Vahlar/projet_elec_meteo/Lucile_Comba/Images/Oscillo_Interruption_Anemometre.jpg

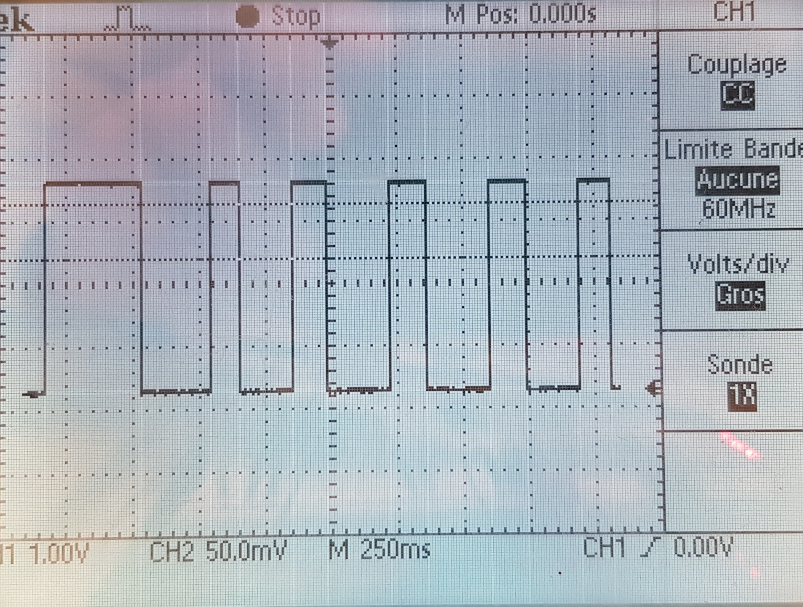
Lucile_Comba/Images/Oscillo_Interruption_Anemometre.jpg
