Vahlar/projet_elec_meteo/Nicolas_Imbard/Nicolas_Imbard.md

CR 10/09/2020:  

- Prise de connaissance du projet.  
- création du repo Git et ajout des collaborateurs.  
- Lecture du travail effectué par la promotion précédente.  

CR 25/09/2020

- rédaction du cahier des charges du projet.
- câblage du BME280 et du FTDI232 à l'ESP32.

CR 08/10/2020

- câblage du TSL2591
- test du TSL2591 et du BME280

CR 22/10/2020

- soudage des prises rj11 femelles
- câble des modules Lora
- mise en place des capteurs de pluviométrie et d'anémométrie pour les tests

CR 19/11/2020

- Câblage et test du pluviomètre
- Analyse du câblage suite à plusieurs problèmes rencontrés
- Test de transmission des trames LoRa

CR 26/11/2020

- Test du code de l'anémomètre (problème de rebonds pour le moment)

CR 03/12/2020

-Absent
