Vahlar/projet_elec_meteo/Présentations/Présentation mi-parcours Météo.pdf

# Présentation mi-parcours Projet Ruche

# Station météologique

1 Guillaume BOUCHARD - Lucile COMBA--ANTONETTI - Nicolas HEISSLER Nicolas IMBARD - Loris MAGNE

I. Présentation du projet
II. | Avancement du projet
III. | Hardware
A. Fonctionnement des capteurs
B. Dimensionnement et câblage
C. Tests du fonctionnement des codes
D. Résolution des problèmes
E. PCB

IV. Développement logiciel
A. Capteur de pression / altitude / humidité / température
B. Capteur de luminosité
C. Pluviomètre
D. Anémomètre
E. Girouette
F. Module LoRa
G. Gestion du mode sommeil
V. | Conclusion | 2

# Sommaire

# I) Présentation

Objectifs du module Météo :

- Relever la température, l’humidité, l’altitude, de la pluviométrie, la direction et la vitesse du vent ;
- Réceptionner les données transmises par les autres modules ;


- Transmettre la totalité des données à la base de données.

# II) Avancement du projet

Mois Tâches | 09 | 10 | 11 | 12 | 01 | 02 | 03 | 04 | 05

Câblage des différents éléments / FTDI

Capteur de pression/altitude/humidité/température

Capteur de luminosité

Pluviomètre

Girouette

Anémomètre

Module LoRa

Gestion du mode sommeil

PCB

# III) Hardware

# A) Fonctionnement des capteurs

Capteur BME

Mesures :

- Pression (300 à 1100 hPa)
- Altitude
Humidité (%)
- Température (-40 à 85°C)

Alimentation :

- min 1.7v
- max 3.6v
I²C interface :
- SCK: serial clock (SCL)
- SDI: data (SDA)


- SDO: Slave address LSB ADC : 16 bit

# III) Hardware

# A) Fonctionnement des capteurs

Capteur TSL

Mesure :

- Luminosité (0,1 à 40 000 lux)

Alimentation :

- min 2.7v
- max 3.6v

I²C interface :

- SCL: serial clock
- SDA: data

ADC : 16 bit

# III) Hardware

# A) Fonctionnement des capteurs

Girouette; Anémomètre; Mesures :; - Précipitation

Pluviomètre

- Orientation du vent
- Vitesse du vent

# III) Hardware

# A) Fonctionnement des capteurs

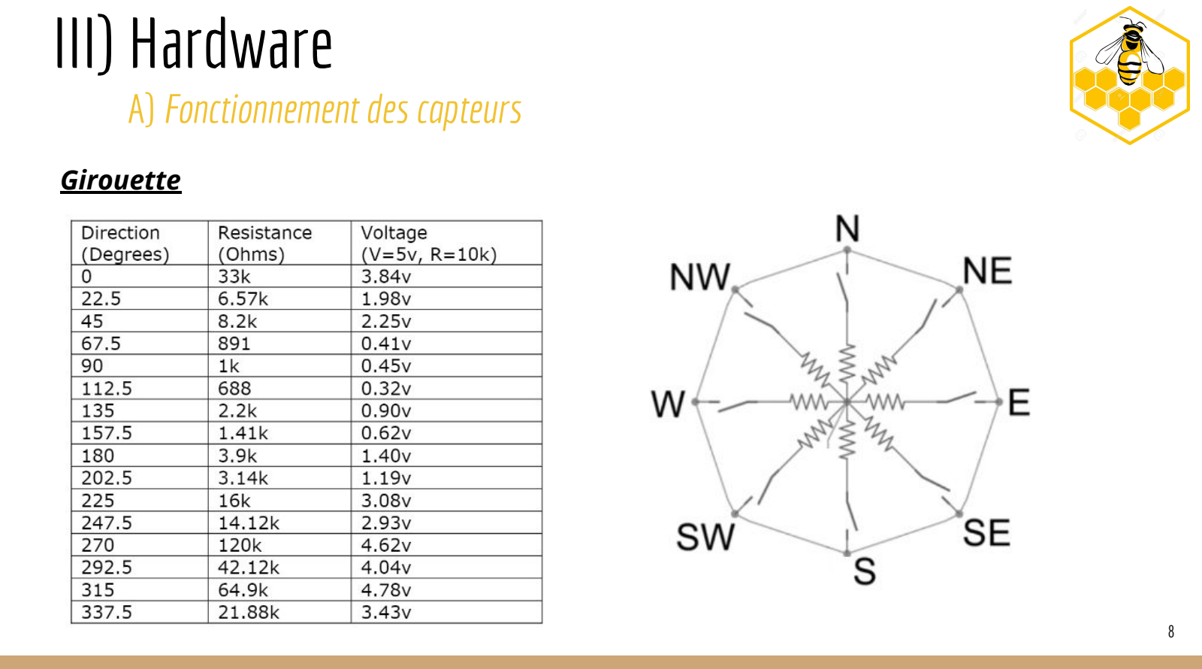
[picture p80: page 8]

Girouette

# III) Hardware

# B) Dimensionnement et câblage

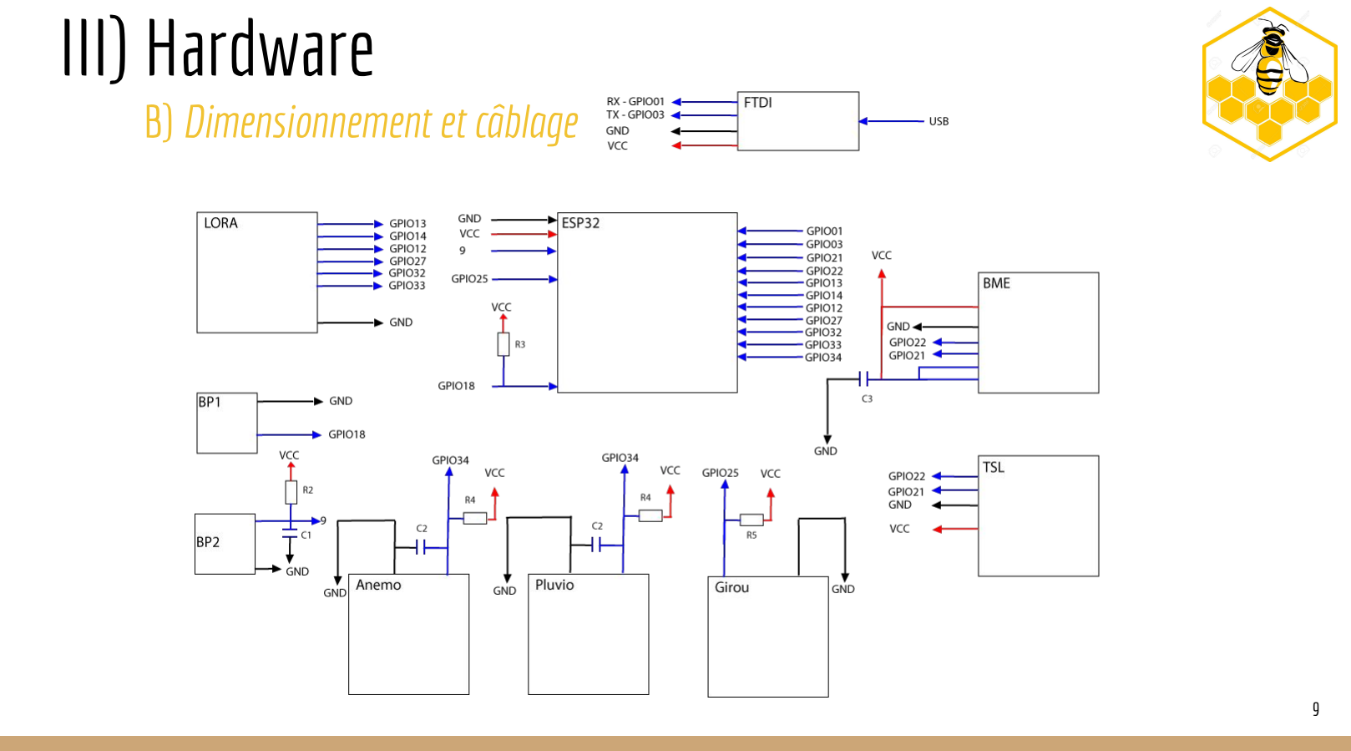
[picture p81: page 9]

# III) Hardware

# C) Tests du fonctionnement des codes

Capteur BME

Récupération des
valeurs, comparaison
avec météo france
Capteur TSL | Récupération des valeurs en Candela

Aucun problème rencontré lors des tests de fonctionnement

Conclusion

# III) Hardware

# C) Tests du fonctionnement des codes

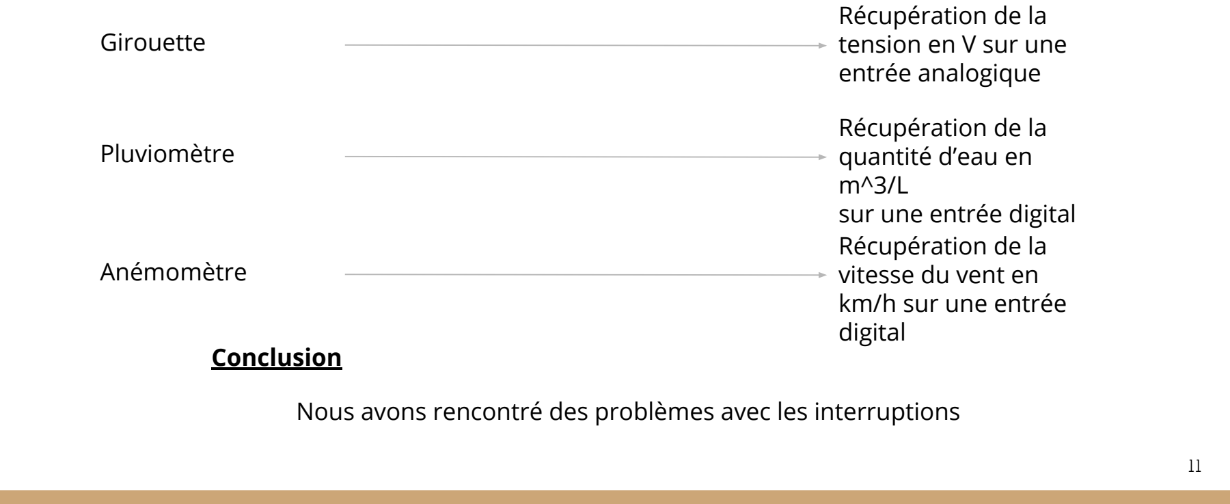
[picture p82: figure]
Girouette; Récupération de la tension en V sur une entrée analogique; Pluviomètre; Récupération de la quantité d’eau en m^3/L sur une entrée digital; Conclusion; Anémomètre; Récupération de la vitesse du vent en km/h sur une entrée digital

Nous avons rencontré des problèmes avec les interruptions

# III) Hardware

# D) Résolution des problèmes

Rajout d’une capacité de 220pF pour éviter les rebonds

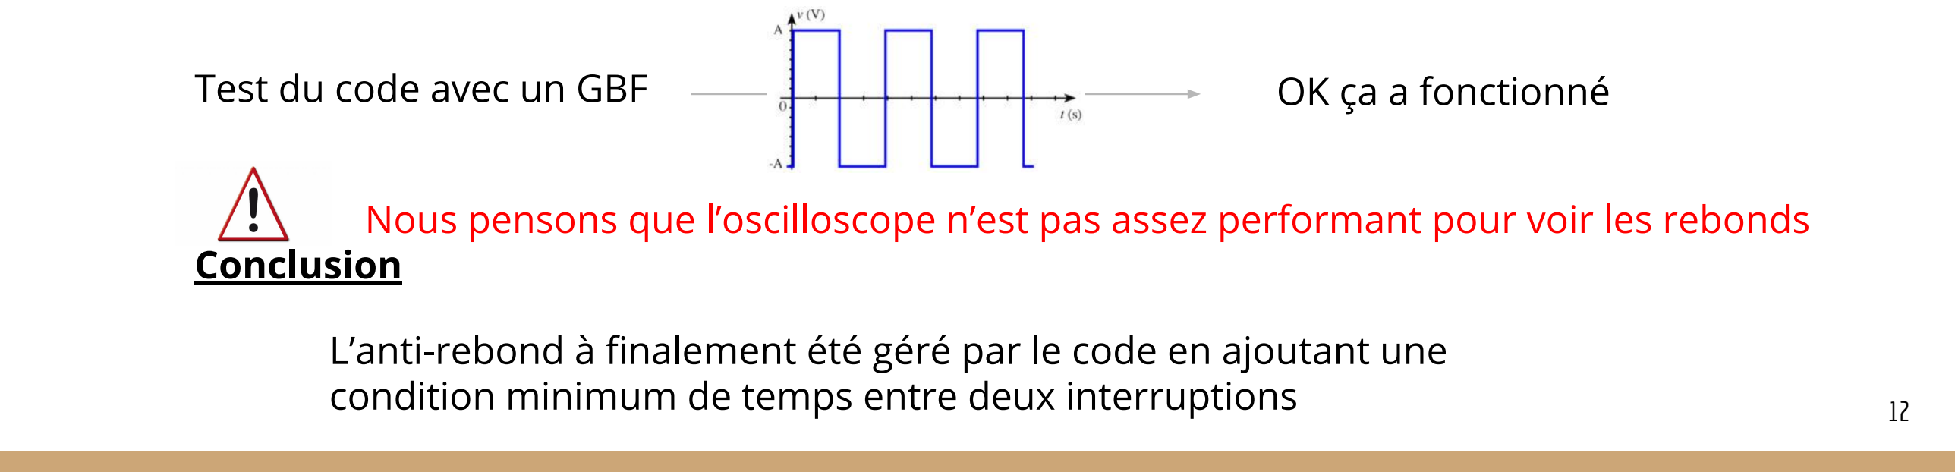
[picture p83: figure]
Conclusion

Test du code avec un GBF | OK ça a fonctionné

Vérification à l'oscilloscope
que les interruptions sont
propres

OK ça a fonctionné
la capacité a bien été dimensionné mais il n’est pas suffisant pour gérer entièrement notre problème d’interruption

L’anti-rebond à finalement été géré par le code en ajoutant une
condition minimum de temps entre deux interruptions

Nous pensons que l’oscilloscope n’est pas assez performant pour voir les rebonds

# III) Hardware

# E) PCB

1. Récupération du PCB existant
2. Suppression des composants inutiles
3. Ajout des librairies pour les composants existants
4. Séparation des différents éléments présents sur la carte en groupe ( acquisition, traitement, communication, action)

# IV) Développement logiciel


# A) Capteur de pression / altitude / humidité / température

Code capteur BME


# IV) Développement logiciel

# B) Capteur luminosité

Code capteur TSL

# IV) Développement logiciel

# C) Pluviomètre

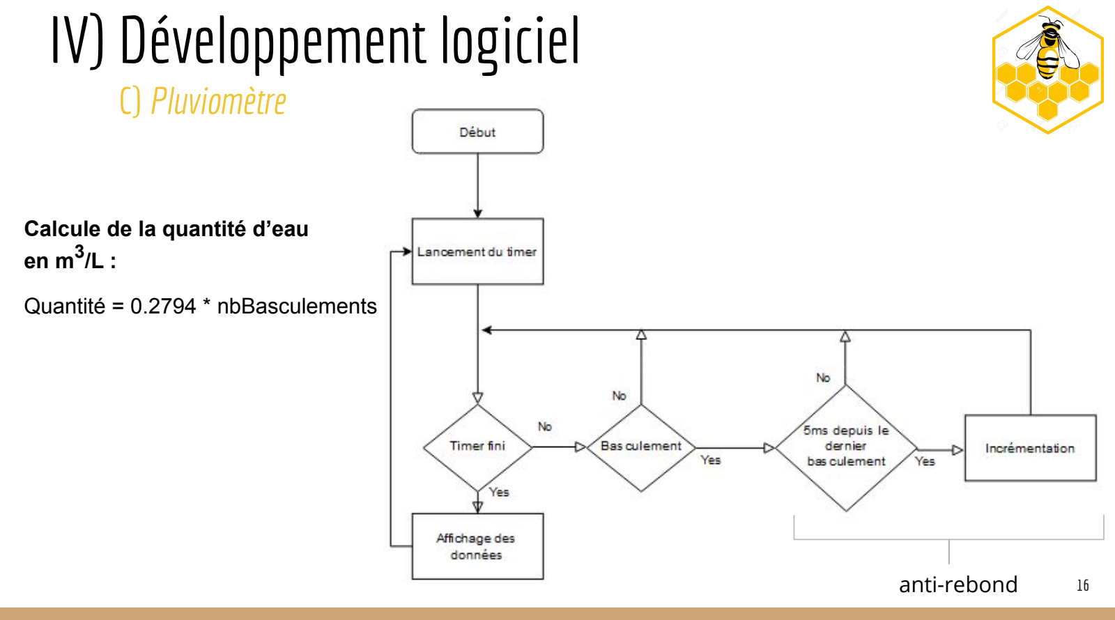
[picture p84: page 16]

anti-rebond 16

Calcule de la quantité d’eau
en m³
/L :

Quantité = 0.2794 * nbBasculements

# IV) Développement logiciel

# F) Anémomètre

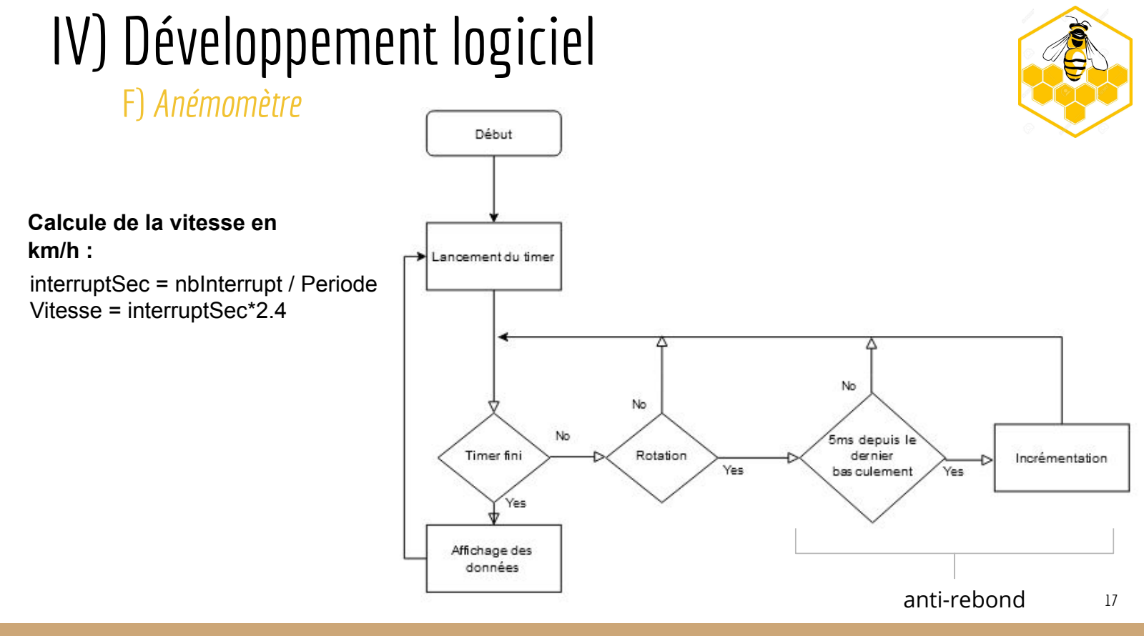
[picture p85: page 17]

anti-rebond | 17

interruptSec = nbInterrupt / Periode Vitesse = interruptSec*2.4

Calcule de la vitesse en
km/h :

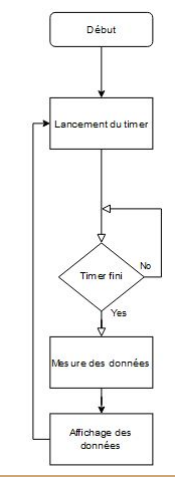
[picture p86: figure]

# IV) Développement logiciel

# E) Girouette

La lecture d'une valeur analogique avec l'ESP32 signifie que l’on peut mesurer différents niveaux de tension entre 0 V et 3,3 V.

La tension mesurée est alors affectée à une valeur comprise entre 0 et 4095,

# IV) Développement logiciel

# E) Girouette

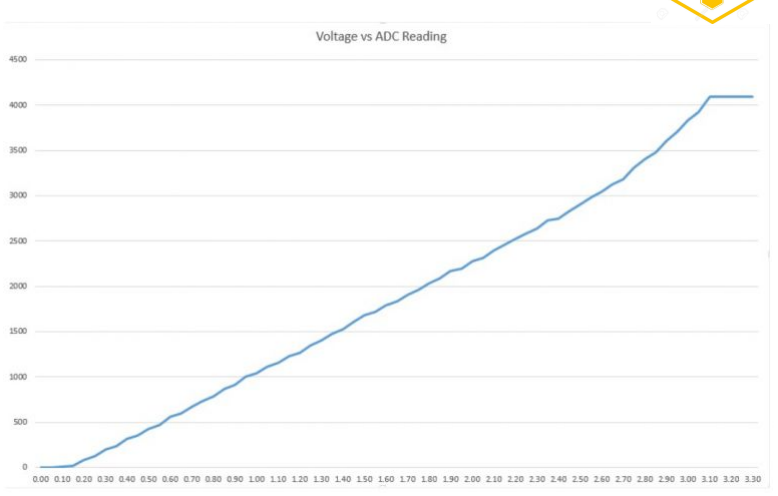
[picture p87: figure]

Problème : comportement non linéaire des broches ESP32 ADC

ESP32 n'est pas capable de distinguer 3,3 V de 3,2 V => même valeur pour les deux tensions: 4095.

De même pour 0 V et 0,1 V, valeur obtenue => 0

# IV) Développement logiciel

# F) Module LoRa

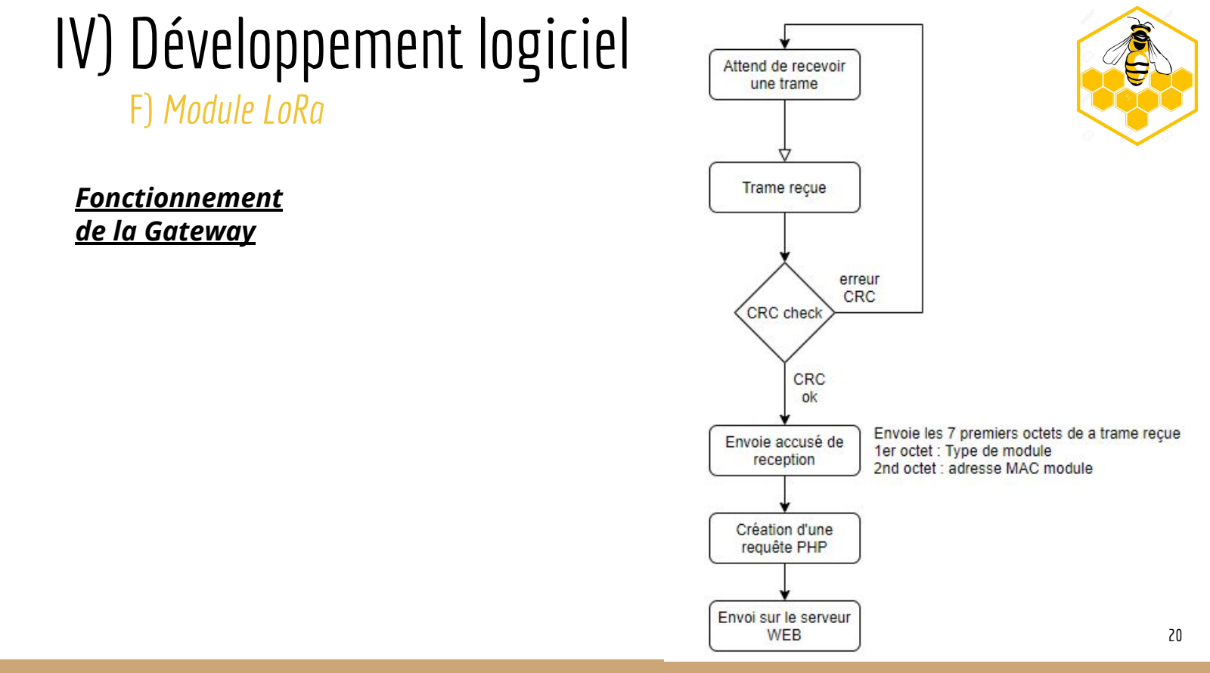
[picture p88: page 20]

Fonctionnement
de la Gateway

# IV) Développement logiciel


# F) Module LoRa

Envoie d’un message

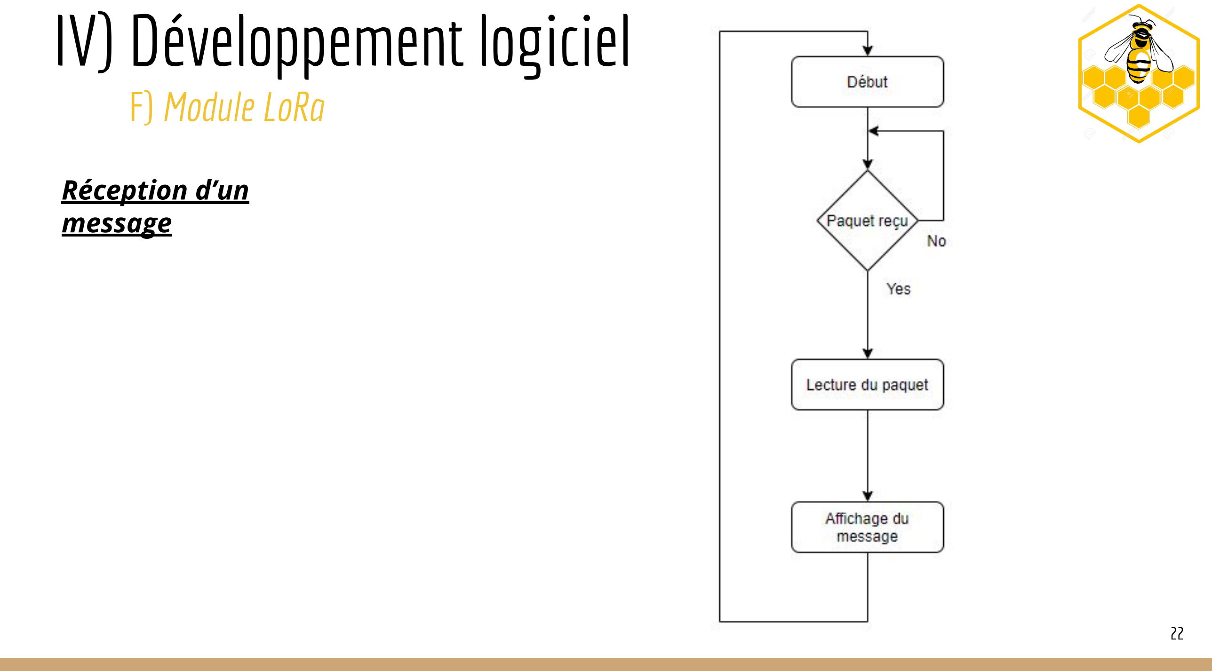
[picture p89: figure]
IV) Développement logiciel; F) Module LoRa; Réception d’un message

# IV) Développement logiciel

# G) Gestion du mode sommeil


# Conclusion

❏ Réalisation du PCB
❏ Test du module LORA
❏ Fin de la réalisation du code et test de la girouette

Merci de votre attention.

# Avez-vous des questions ?
