Vahlar/projet_elec_meteo/Loris_Magne/Fonctionnement Gateway.PNG

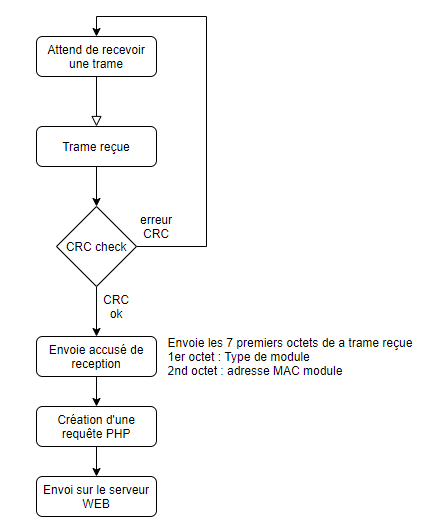
Loris_Magne/Fonctionnement Gateway.PNG
