Vahlar/projet_elec_meteo/Guillaume_Bouchard/Photo_test-continuité/Schema-test-de-continuité.png

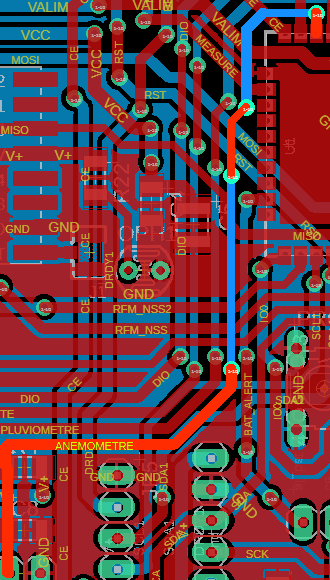
Guillaume_Bouchard/Photo_test-continuité/Schema-test-de-continuité.png
