Vahlar/projet_elec_meteo/Guillaume_Bouchard/ESP_LoRa_1.5.brd

## EAGLE design Guillaume_Bouchard/ESP_LoRa_1.5.brd (2021-04-01)

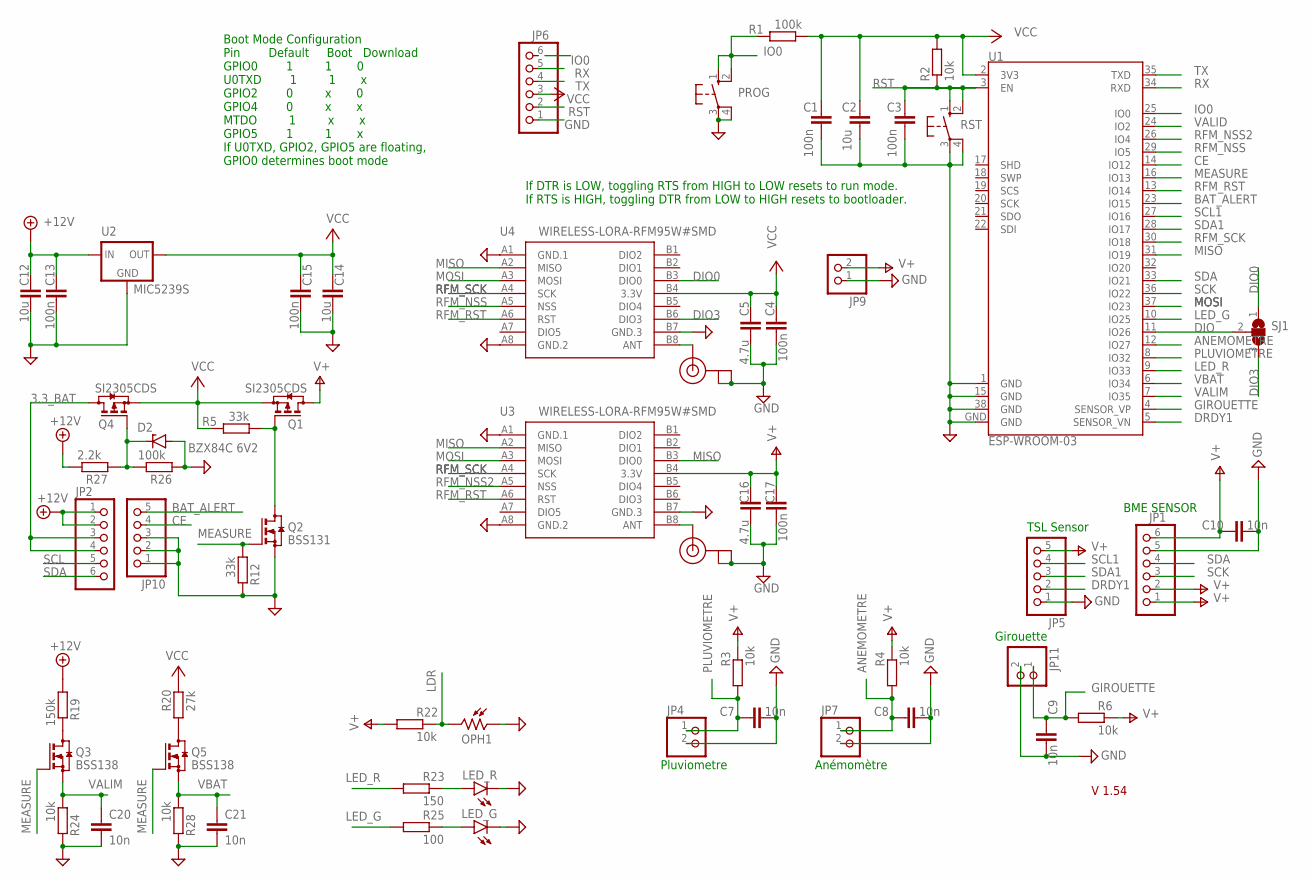
[picture p92: schematic ESP_LoRa_1.5.sch]

Parts:
C1, C3, C4, C13, C15, C17: 100n; C1206
C2, C12, C14: 10u; C1210
C5, C16: 4.7u; C1210
C7, C8, C9, C10, C20, C21: 10n; C1206
D2: BZX84C 6V2; TO236
J1, J2: U.FL
JP1, JP2, JP6: PINHD-1X6; 1X06
JP4, JP7, JP9, JP11: PINHD-1X2; 1X02
JP5, JP10: PINHD-1X5; 1X05
LED_G: LEDSMT1206; 1206
LED_R: LEDSMT1206; 1206
OPH1: VT93N2; VT900
PROG: 10-XX; B3F-10XX
Q1, Q4: SI2305CDS; SOT23
Q2: BSS131; SOT23
Q3, Q5: BSS138; SOT23
R1, R26: 100k; R1206
R2, R3, R4, R6, R22, R24, R28: 10k; R1206
R5, R12: 33k; R1206
R19: 150k; R1206
R20: 27k; R1206
R23: 150; R1206
R25: 100; R1206
R27: 2.2k; R1206
RST: 10-XX; B3F-10XX
SJ1: SJ2W; SJ_2
U1: ESP-WROOM-03
U2: MIC5239S; SOT223
U3, U4: WIRELESS-LORA-RFM95W#SMD

Connections:
3.3_BAT: JP2.3, JP2.4, Q4.3 (D)
+12V: C12.1, C13.1, JP2.1, JP2.2, R19.1, R27.2, U2.1 (IN)
ANEMOMETRE: C8.1, JP7.1, R4.1, U1.12 (IO27)
ANT2: J2.3 (SIGNAL), U4.B8 (ANT)
ANT3: J1.3 (SIGNAL), U3.B8 (ANT)
BAT_ALERT: JP10.5, U1.23 (IO15)
CE: JP10.4, U1.14 (IO12)
DIO: SJ1.2, U1.11 (IO26)
DIO0: SJ1.1, U4.B3 (DIO0)
DIO3: SJ1.3, U4.B6 (DIO3)
DRDY1: JP5.2, U1.5 (SENSOR_VN)
GIROUETTE: C9.1, JP11.1, R6.1, U1.4 (SENSOR_VP)
GND: C1.2, C2.2, C3.2, C4.2, C5.2, C7.2, C8.2, C9.2, C10.2, C12.2, C13.2, C14.2, C15.2, C16.2, C17.2, C20.2, C21.2, D2.A, J1.1 (GND), J1.2 (GND), J2.1 (GND), J2.2 (GND), JP1.5, JP4.2, JP5.1, JP6.1, JP7.2, JP9.1, JP10.1, JP10.2, JP10.3, JP11.2, LED_G.C, LED_R.C, OPH1.1, PROG.3, PROG.4 (P1), Q2.2 (S), R12.2, R24.2, R26.1, R28.2, RST.3, RST.4 (P1), U1.1 (GND), U1.15 (GND), U1.38 (GND), U1.GND, U2.2 (GND), U2.4 (GND), U3.A1 (GND.1), U3.A8 (GND.2), U3.B7 (GND.3), U4.A1 (GND.1), U4.A8 (GND.2), U4.B7 (GND.3)
IO0: PROG.1 (S), PROG.2 (S1), R1.2, U1.25 (IO0)
LDR: OPH1.2, R22.2
LED_G: R25.1, U1.10 (IO25)
LED_R: R23.1, U1.9 (IO33)
MEASURE: Q2.1 (G), Q3.1 (G), Q5.1 (G), R12.1, U1.16 (IO13)
MISO: U1.31 (IO19), U3.A2 (MISO), U3.B3 (DIO0), U4.A2 (MISO)
MOSI: U1.37 (IO23), U3.A3 (MOSI), U4.A3 (MOSI)
unnamed: Q1.1 (G), Q2.3 (D), R5.1
unnamed: Q3.3 (D), R19.2
unnamed: Q5.3 (D), R20.1
unnamed: LED_R.A, R23.2
unnamed: LED_G.A, R25.2
unnamed: D2.C, Q4.1 (G), R26.2, R27.1
PLUVIOMETRE: C7.1, JP4.1, R3.1, U1.8 (IO32)
RFM_NSS: U1.29 (IO5), U4.A5 (NSS)
RFM_NSS2: U1.26 (IO4), U3.A5 (NSS)
RFM_RST: U1.13 (IO14), U3.A6 (RST), U4.A6 (RST)
RFM_SCK: U1.30 (IO18), U3.A4 (SCK), U4.A4 (SCK)
RST: C3.1, JP6.2, R2.1, RST.1 (S), RST.2 (S1), U1.3 (EN)
RX: JP6.5, U1.34 (RXD)
SCK: JP1.3, U1.36 (IO22)
SCL: JP2.5
SCL1: JP5.4, U1.27 (IO16)
SDA: JP1.4, JP2.6, U1.33 (IO21)
SDA1: JP5.3, U1.28 (IO17)
TX: JP6.4, U1.35 (TXD)
V+: C10.1, C16.1, C17.1, JP1.1, JP1.2, JP1.6, JP5.5, JP9.2, Q1.3 (D), R3.2, R4.2, R6.2, R22.1, U3.B4 (3.3V)
VALID: U1.24 (IO2)
VALIM: C20.1, Q3.2 (S), R24.1, U1.7 (IO35)
VBAT: C21.1, Q5.2 (S), R28.1, U1.6 (IO34)
VCC: C1.1, C2.1, C4.1, C5.1, C14.1, C15.1, JP6.3, Q1.2 (S), Q4.2 (S), R1.1, R2.2, R5.2, R20.2, U1.2 (3V3), U2.3 (OUT), U4.B4 (3.3V)

Notes on the sheet:
If DTR is LOW, toggling RTS from HIGH to LOW resets to run mode. If RTS is HIGH, toggling DTR from LOW to HIGH resets to bootloader.
Boot Mode Configuration Pin Default Boot Download GPIO0 1 1 0 U0TXD 1 1 x GPIO2 0 x 0 GPIO4 0 x x MTDO 1 x x GPIO5 1 1 x If U0TXD, GPIO2, GPIO5 are floating, GPIO0 determines boot mode
V 1.54
TSL Sensor
BME SENSOR
Pluviometre
Anémomètre
Girouette

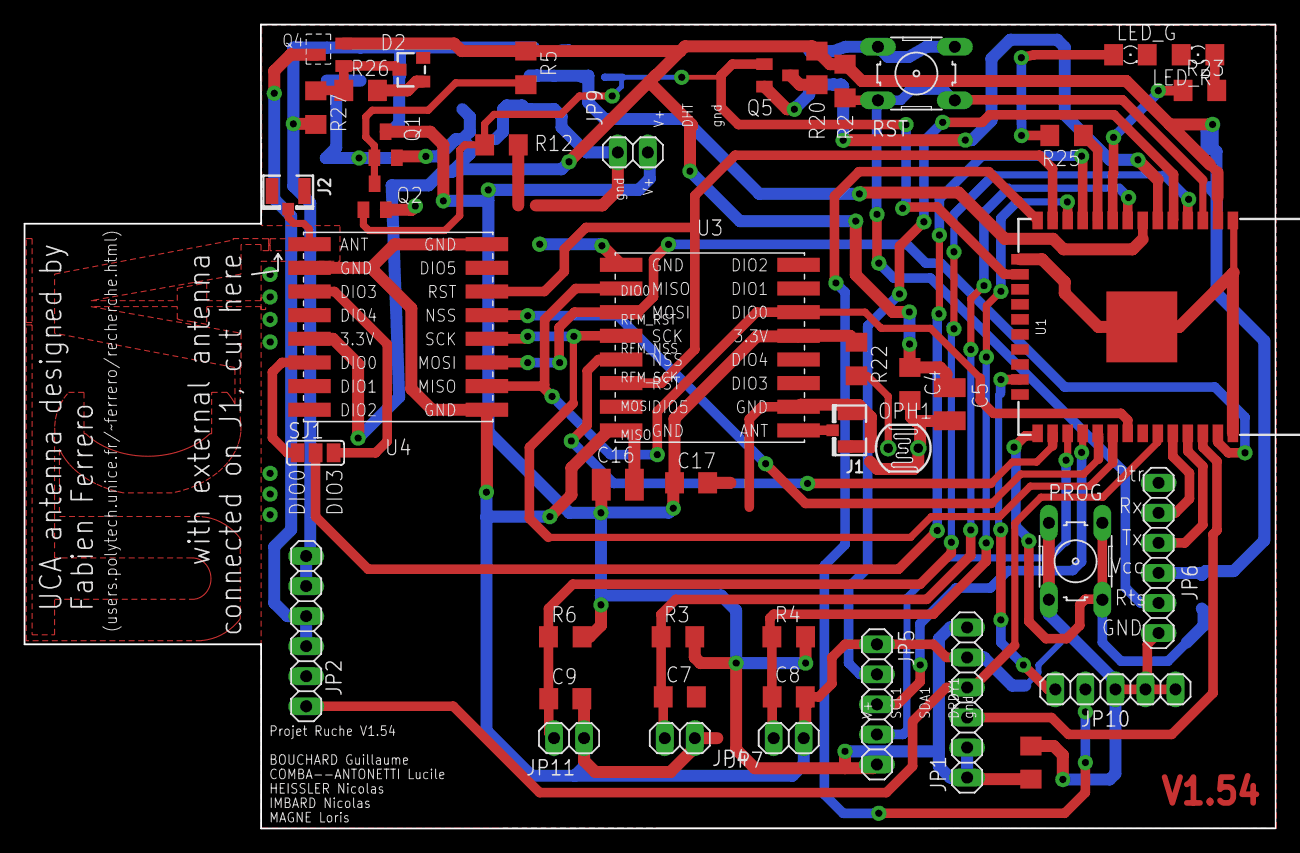
[picture p93: board ESP_LoRa_1.5.brd from above]

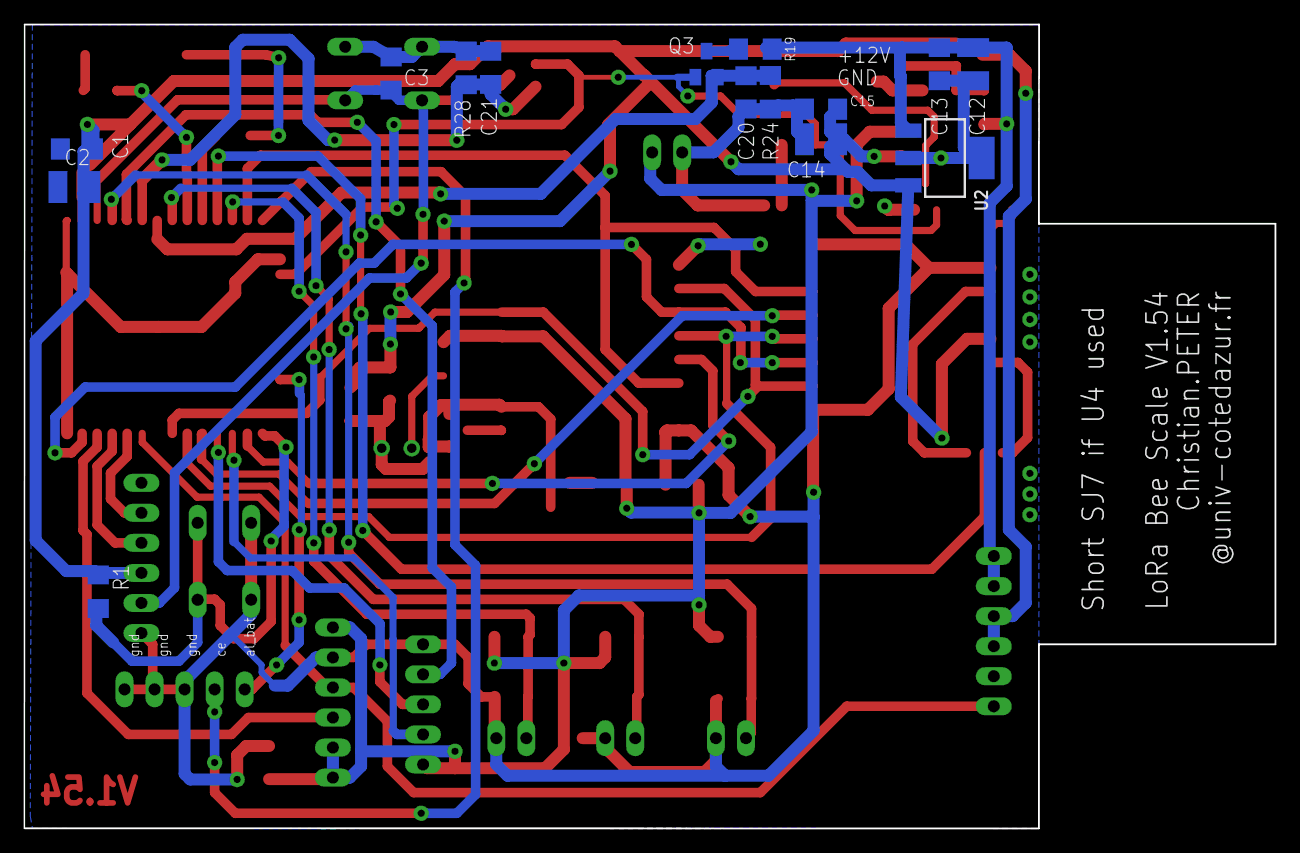
[picture p94: board ESP_LoRa_1.5.brd from below]

Board: 2 copper layers, 105.8 x 68.0 mm, 60 parts (15 on the bottom side), 42 nets.
