Vahlar/projet_elec_meteo/ESP_LoRa_Weather.brd

## EAGLE design ESP_LoRa_Weather.brd (2020-09-10)

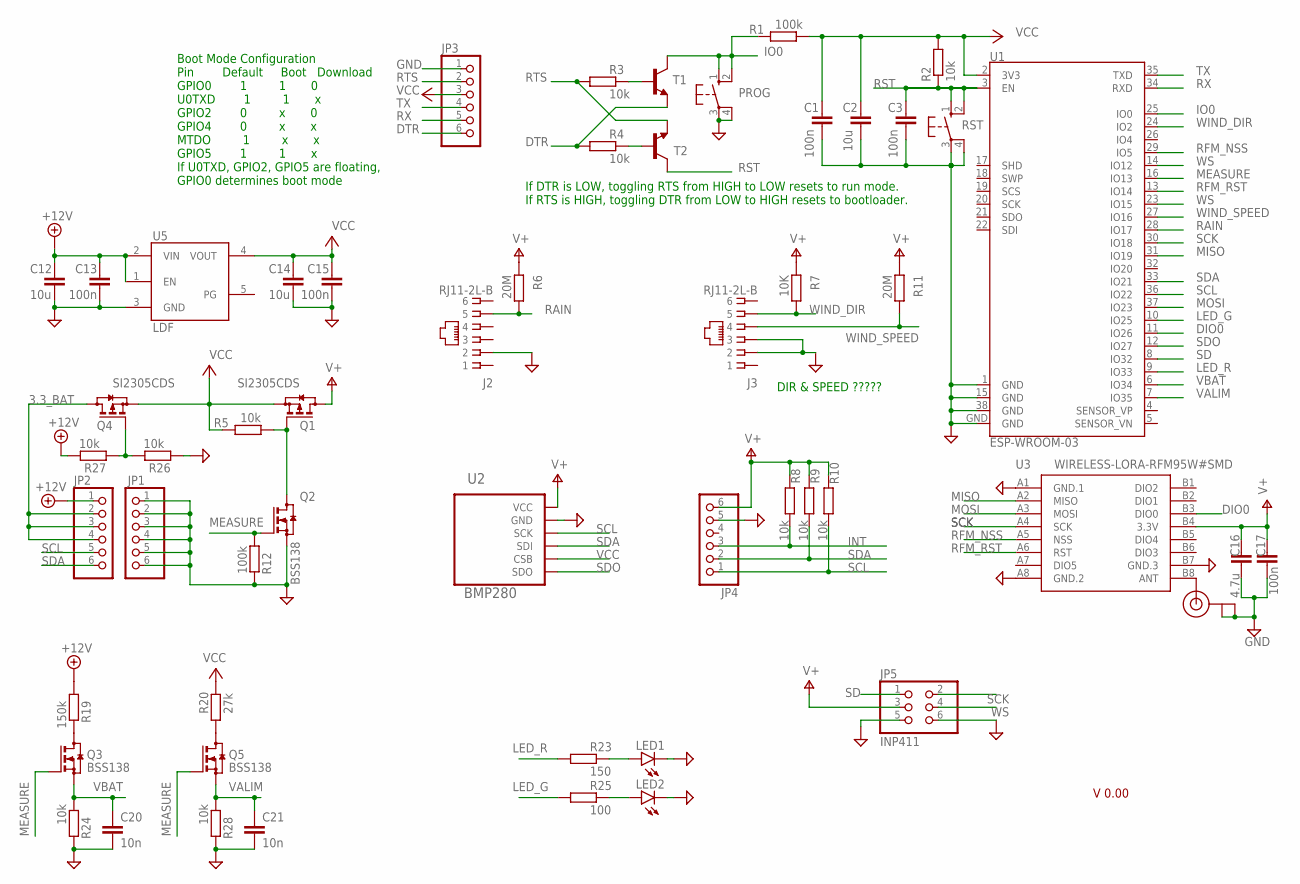
[picture p95: schematic ESP_LoRa_Weather.sch]

Parts:
C1, C3, C13, C15, C17: 100n; C1206
C2, C12, C14: 10u; C1210
C16: 4.7u; C1210
C20, C21: 10n; C1206
J1: U.FL
J2, J3: RJ11-2L-B; RJ11-NO_SHIELD
JP1, JP2, JP3, JP4: PINHD-1X6; 1X06
JP5: INP411; 2X03
LED1, LED2: LEDCHIPLED_0805; CHIPLED_0805
PROG: 10-XX; B3F-10XX
Q1, Q4: SI2305CDS; SOT23
Q2, Q3, Q5: BSS138; SOT23
R1, R12: 100k; R1206
R2, R3, R4, R5, R8, R9, R10, R24, R26, R27, R28: 10k; R1206
R6, R11: 20M; R1206
R7: 10K; R1206
R19: 150k; R1206
R20: 27k; R1206
R23: 150; R1206
R25: 100; R1206
RST: 10-XX; B3F-10XX
T1, T2: MMBT2222ALT1-NPN-SOT23-BEC; SOT23-BEC
U1: ESP-WROOM-03
U2: BMP280
U3: WIRELESS-LORA-RFM95W#SMD
U5: LDF3.3; PPAK

Connections:
3.3_BAT: JP2.2, JP2.3, JP2.4, Q4.3 (D)
+12V: C12.1, C13.1, JP2.1, R19.1, R27.2, U5.1 (EN), U5.2 (VIN)
DIO0: U1.11 (IO26), U3.B3 (DIO0)
DTR: JP3.6, R4.1, T1.E
GND: C1.2, C2.2, C3.2, C12.2, C13.2, C14.2, C15.2, C16.2, C17.2, C20.2, C21.2, J1.1 (GND), J1.2 (GND), J2.2, J3.2, J3.3, JP1.1, JP1.2, JP1.3, JP1.4, JP1.5, JP1.6, JP3.1, JP4.5, JP5.5, JP5.6, LED1.C, LED2.C, PROG.3, PROG.4 (P1), Q2.2 (S), R12.2, R24.2, R26.1, R28.2, RST.3, RST.4 (P1), U1.1 (GND), U1.15 (GND), U1.38 (GND), U1.GND, U2.GND, U3.A1 (GND.1), U3.A8 (GND.2), U3.B7 (GND.3), U5.3 (GND)
INT: JP4.3, R8.2
IO0: PROG.1 (S), PROG.2 (S1), R1.2, T1.C, U1.25 (IO0)
LED_G: R25.1, U1.10 (IO25)
LED_R: R23.1, U1.9 (IO33)
MEASURE: Q2.1 (G), Q3.1 (G), Q5.1 (G), R12.1, U1.16 (IO13)
MISO: U1.31 (IO19), U3.A2 (MISO)
MOSI: U1.37 (IO23), U3.A3 (MOSI)
unnamed: Q1.1 (G), Q2.3 (D), R5.1
unnamed: Q3.3 (D), R19.2
unnamed: J1.3 (SIGNAL), U3.B8 (ANT)
unnamed: Q5.3 (D), R20.1
unnamed: LED1.A, R23.2
unnamed: LED2.A, R25.2
unnamed: R3.2, T1.B
unnamed: R4.2, T2.B
unnamed: Q4.1 (G), R26.2, R27.1
RAIN: J2.5, R6.2, U1.28 (IO17)
RFM_NSS: U1.29 (IO5), U3.A5 (NSS)
RFM_RST: U1.13 (IO14), U3.A6 (RST)
RST: C3.1, R2.1, RST.1 (S), RST.2 (S1), T2.C, U1.3 (EN)
RTS: JP3.2, R3.1, T2.E
RX: JP3.5, U1.34 (RXD)
SCK: JP5.2, U1.30 (IO18), U3.A4 (SCK)
SCL: JP2.5, JP4.1, R10.2, U1.36 (IO22), U2.SCK
SD: JP5.1, U1.8 (IO32)
SDA: JP2.6, JP4.2, R9.2, U1.33 (IO21), U2.SDI
SDO: U1.12 (IO27), U2.SD0 (SDO)
TX: JP3.4, U1.35 (TXD)
V+: C16.1, C17.1, JP4.6, JP5.3, Q1.3 (D), R6.1, R7.1, R8.1, R9.1, R10.1, R11.1, U2.VCC, U3.B4 (3.3V)
VALIM: C21.1, Q5.2 (S), R28.1, U1.7 (IO35)
VBAT: C20.1, Q3.2 (S), R24.1, U1.6 (IO34)
VCC: C1.1, C2.1, C14.1, C15.1, JP3.3, Q1.2 (S), Q4.2 (S), R1.1, R2.2, R5.2, R20.2, U1.2 (3V3), U2.CSB, U5.4 (VOUT)
WIND_DIR: J3.5, R7.2, U1.24 (IO2)
WIND_SPEED: J3.4, R11.2, U1.27 (IO16)
WS: JP5.4, U1.14 (IO12), U1.23 (IO15)

Notes on the sheet:
If DTR is LOW, toggling RTS from HIGH to LOW resets to run mode. If RTS is HIGH, toggling DTR from LOW to HIGH resets to bootloader.
Boot Mode Configuration Pin Default Boot Download GPIO0 1 1 0 U0TXD 1 1 x GPIO2 0 x 0 GPIO4 0 x x MTDO 1 x x GPIO5 1 1 x If U0TXD, GPIO2, GPIO5 are floating, GPIO0 determines boot mode
V 0.00
DIR & SPEED ?????

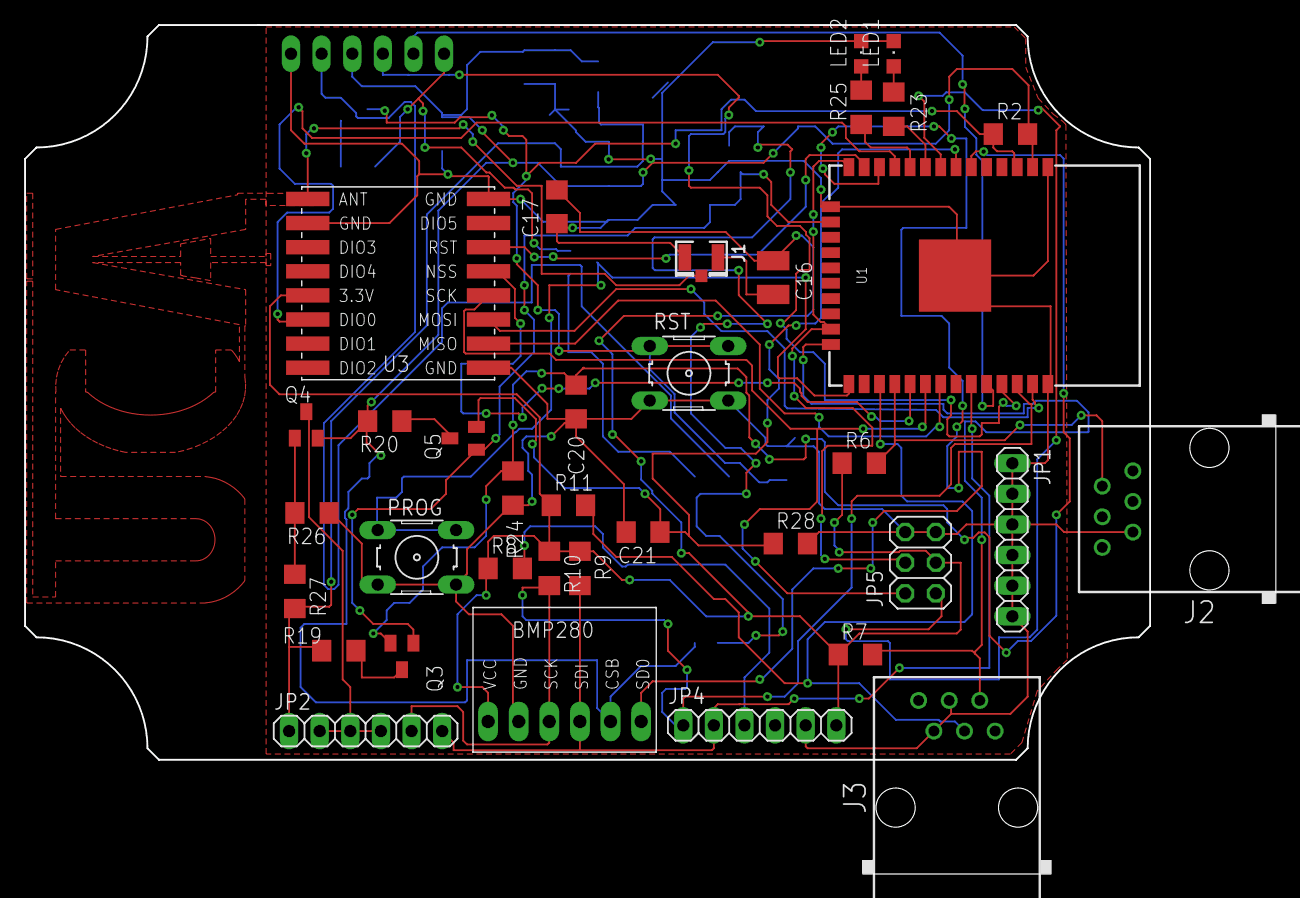
[picture p96: board ESP_LoRa_Weather.brd from above]

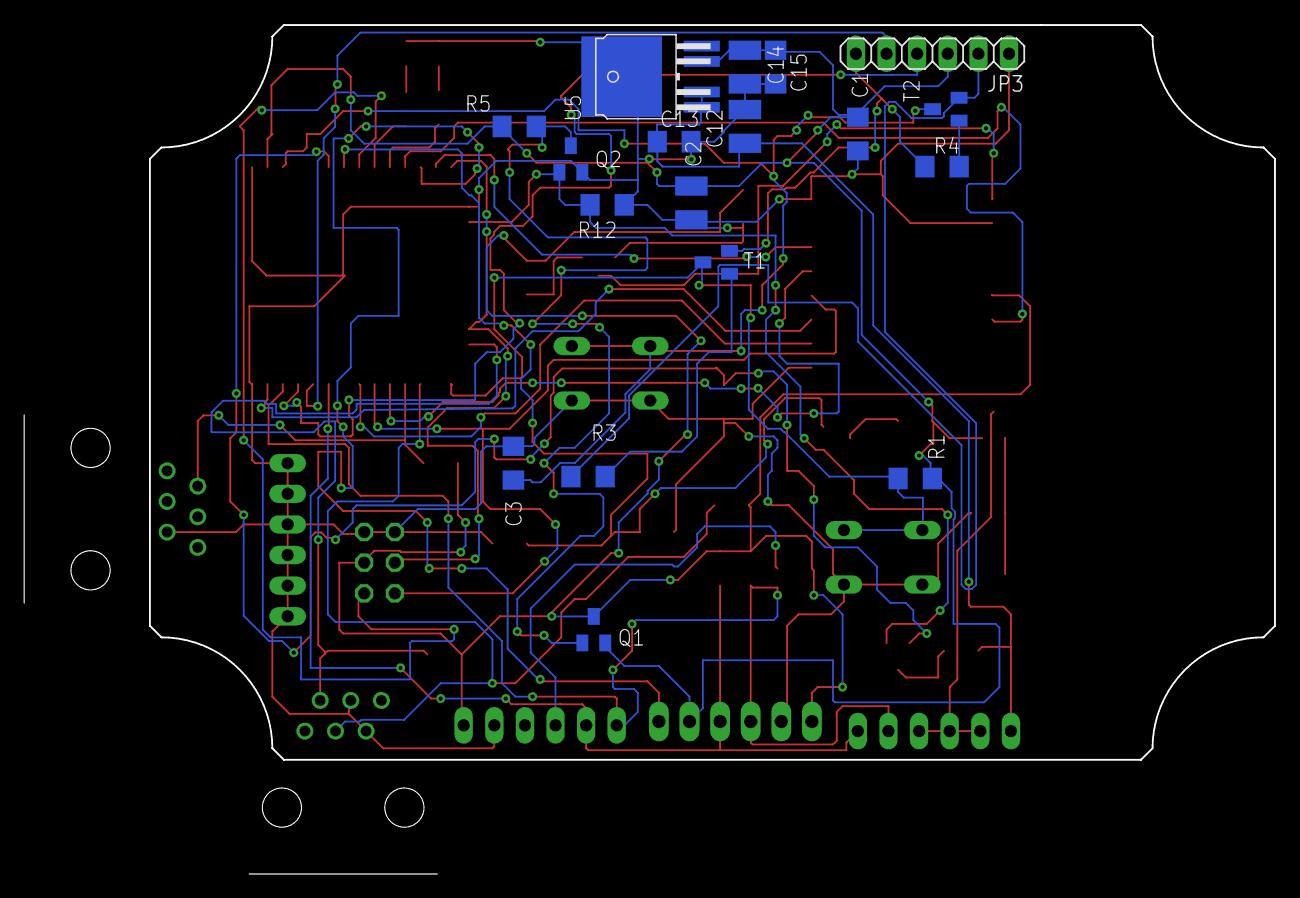
[picture p97: board ESP_LoRa_Weather.brd from below]

Board: 2 copper layers, 93.3 x 61.0 mm, 54 parts (18 on the bottom side), 40 nets.
