Vahlar/projet_elec_meteo/(commit log)

2020-09-10 add docs
    [ESP_LoRa_Weather.brd, ESP_LoRa_Weather.sch]
2020-09-10 Suppression du fichier inutile + copie du code arduino
2020-09-10 Suppression de test + Mise a jour du document taches projet
2020-09-10 Mise à jour du fichier des tâches par séance
2020-09-25 -Mise à jour du code 1.0 -> 1.1 -Création d'un fichier test pour le capteur BME -Création d'un fichier texte avec des infos sur le projet pour mon utilisation
2020-09-25 -Modification du fichier de test du capteur BME -Création du fichier de test du capteur TSL
2020-10-08 -Mise à jour du fichier de suivi de séance -Création d'un fichier de test pour le module LoRa
2020-10-22 Schéma de câblage carte RF96 LoRa
2020-10-22 -Création/Modification des fichiers de tests pour les modules LoRa -Mise à jour du fichier de suivi d'activités de séance
2020-11-19 Ajout des codes donnés par le prof (gateway et balance)
2020-11-26 -Modification des fichiers de test anémomètre et pluviomètre
2020-11-26 -Changement du code de test d'envoi de commande LoRa -Modification du fichier de suivi de séance -Mise à jour du programme arduino complet (en cours de construction)
2020-12-03 - Modification du code de test de l'anemomètre - Ajout d'une photo prise sur un oscillo (interruption anemometre) - Ajout de la documentation des capteurs météo
2020-12-04 -Modification fonctionnelle du code de l'anémometre -Modification fonctionnelle du code du pluviometre -Changement de l'image de l'oscillo
2020-12-04 -Modification du test de l'anémometre -Modification du test du pluviometre -Nouveau fichier de test pluviometre+deepSleep
2020-12-10 Modification du code de la girouette
2020-12-17 -Modification du code de deepSleep -MAJ du doc des activités de séances
2021-01-08 -Powerpoint + ordinogramme + code deepsleep
2021-01-29 -Changement du fichier de suivi pour mise en page du fichier md
2021-01-29 -Développement du code deepSleep avec des méthodes à jour -Ancien code de test du deepsleep passé en DEPRECATED -Développement des codes d'envoi/réception pour le module LoRa -Mise à jour du fichier 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
2021-01-29 -Update du fichier de suivi
2021-02-12 -Modification du code de reception sur module LoRa pour s'adapter au câblage et à la fréquence utilisée pour l'envoi
2021-02-19 -Création d'un code de test pour envoi/reception via 2 module LoRa sur un seul ESP32 -Mise à jour du fichier de suivi pour la séance dela semaine dernière -Passage de la version 1.1 en 1.0 BETA 1 (lo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
2021-03-05 -Maj du fichier de suivi pour le 19/02/2021
2021-03-19 Tableaux de correspondances tension en fonction de la direction du vent Girouette Travail sur la présentation finale
    [Girouette Tracé Vout = f(Vin) get_raw (1).xlsx, Girouette Tracé Vout = f(Vin) get_raw.xlsx]
2021-03-19 Mise à jour tableau des correspondance Girouette
    [Girouette Tracé Vout = f(Vin) get_raw (1).xlsx, Girouette Tracé Vout = f(Vin) get_raw.xlsx, Tableau_Girouette.xlsx]
2021-04-01 maj PCB
    [BOM_PART_METEO.csv, BOM_VALUE_METEO.csv, ESP_LoRa_1.0.brd, ESP_LoRa_1.0.sch, ESP_LoRa_1.1.brd, ESP_LoRa_1.1.sch, ESP_LoRa_1.2.brd, ESP_LoRa_1.2.sch]
2021-04-01 Shéma élec fonctionnement Girouette Mise à jour graphique tableau de correspondance Girouette
    [Tableau_Girouette.xlsx]
2021-04-02 Modification des code de tests de reception LoRa pour reception avec interruption Remplissage du fichier de suivi de travail de séance
2021-04-15 -Code principal modifié -Fichier de suivi rempli
