Vahlar/projet_elec_meteo/(notices)

Notices in the files:
parts and their libraries:
diy-modules: Released under the Creative Commons Attribution 4.0 International License: http://creativecommons.org/licenses/by/4.0
micrel: Copyright (C) 2008, Bob Starr
SparkFun-IC-Conversion: Licensing: Creative Commons ShareAlike 4.0 International - https://creativecommons.org/licenses/by-sa/4.0
